bikerglen/usb-volume-knob/mechanical/puck_v2_v16_grayhill_encoder_v7_bottom.stl

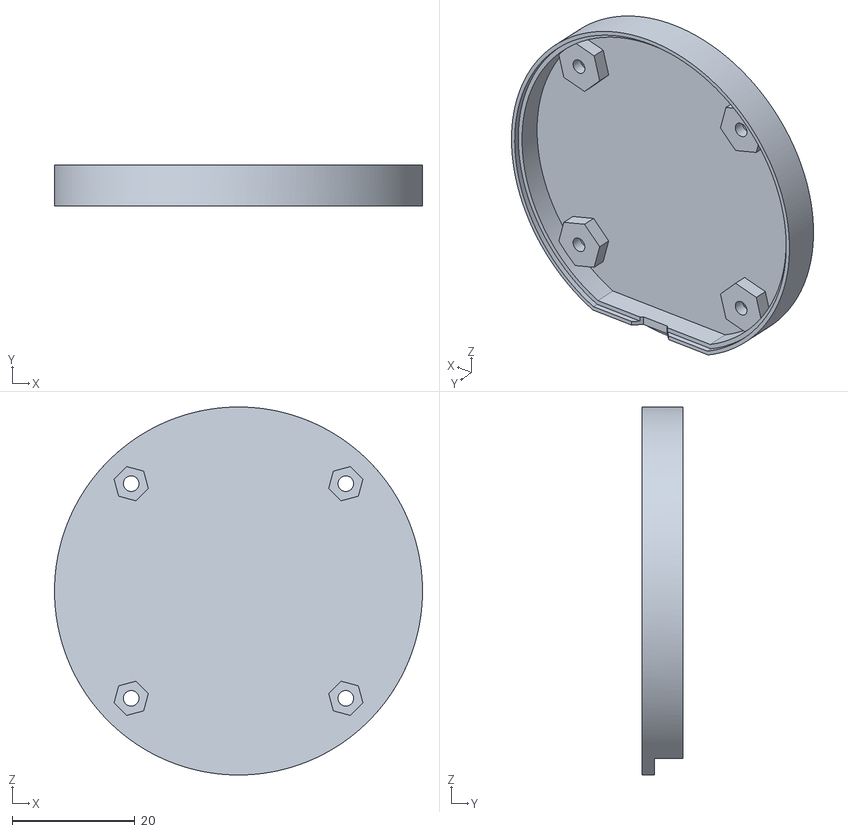
[picture p1: CAD file, 2020-03-15]
mechanical/puck_v2_v16_grayhill_encoder_v7_bottom.stl
60.0 x 6.65 x 60.0
