bikerglen/usb-volume-knob/mechanical/puck_v2_v16_grayhill_encoder_v7_top.stl

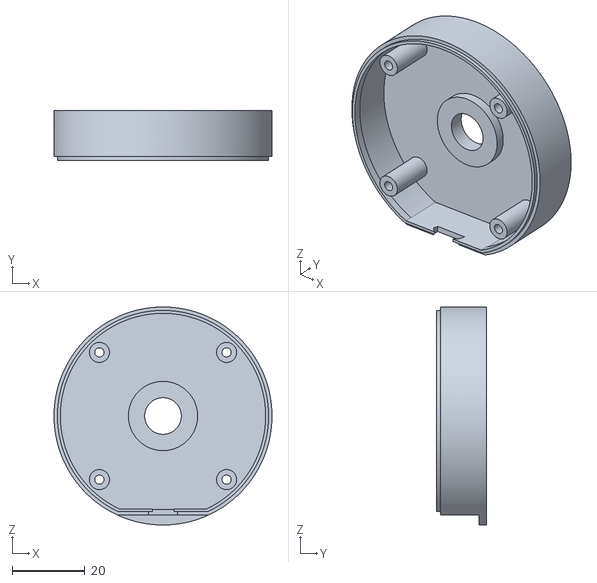
[picture p2: CAD file, 2020-03-15]
mechanical/puck_v2_v16_grayhill_encoder_v7_top.stl
60.0 x 13.6 x 60.0
