bikerglen/usb-volume-knob/(list of files, cad)

Other CAD files:
mechanical/puck_v2_v16_grayhill_encoder v9.f3z
