bikerglen/usb-volume-knob/boards/grayhill-knob-board.brd

## EAGLE design boards/grayhill-knob-board.brd (2020-03-15)

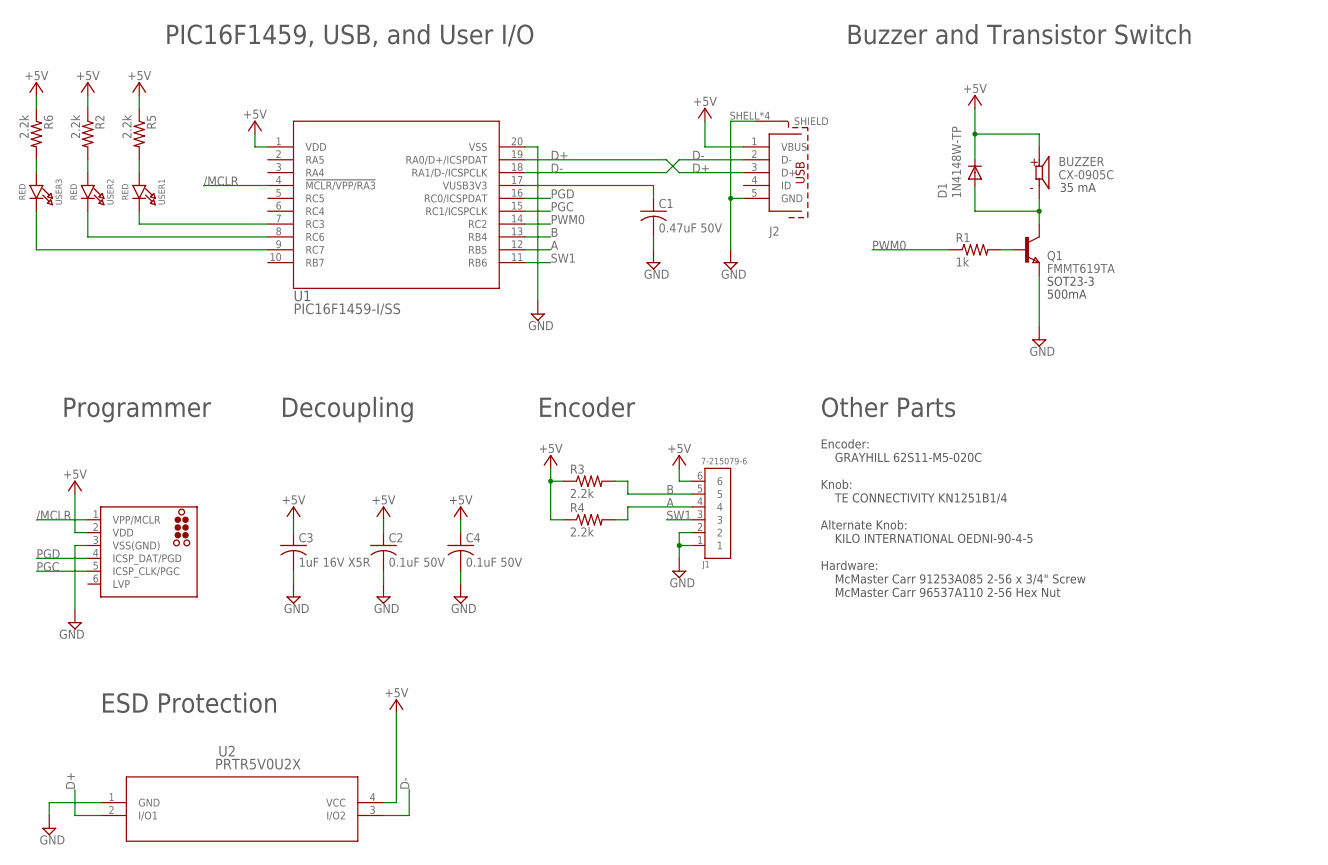
[picture p3: schematic grayhill-knob-board.sch]

Parts:
BUZZER: CX-0905C; CUI_CX-0905C
C1: 0.47uF 50V; C1206K; MFR_PART_NO C1206C474K5RACTU
C2, C4: 0.1uF 50V; C1206K; MFR_PART_NO C1206S104M5RACTU
C3: 1uF 16V X5R; C1210; MFR_PART_NO C1210C105K4PACTU
D1: 1N4148W-TP; SOD123
J1: 7-215079-6; TE_7-215079-6
J2: 629105136821
J3: TC2030-MCP-NL
Q1: FMMT619TA; SOT-23
R1: 1k; R0805
R2, R3, R4, R5, R6: 2.2k; R0805
U1: PIC16F1459-I/SS; SSOP20_MC
U2: PRTR5V0U2X; SOT143B
USER1, USER2, USER3: RED; CHIPLED_0805_NOOUTLINE

Connections:
+5V: BUZZER.P, C2.1, C3.1, C4.1, D1.C, J1.6, J2.1 (VBUS), J3.2 (VDD), R2.1, R3.1, R4.1, R5.1, R6.1, U1.1 (VDD), U2.4 (VCC)
/MCLR: J3.1 (VPP/MCLR), U1.4 (!MCLR/VPP/RA3)
A: J1.4, R4.2, U1.12 (RB5)
B: J1.5, R3.2, U1.13 (RB4)
D+: J2.3 (D+), U1.19 (RA0/D+/ICSPDAT), U2.2 (I/O1)
D-: J2.2 (D-), U1.18 (RA1/D-/ICSPCLK), U2.3 (I/O2)
GND: C1.2, C2.2, C3.2, C4.2, J1.1, J1.2, J2.5 (GND), J2.SHELL (SHIELD), J2.SHELL1 (SHIELD), J2.SHELL2 (SHIELD), J2.SHELL3 (SHIELD), J3.3 (VSS(GND)), Q1.2 (E), U1.20 (VSS), U2.1 (GND)
unnamed: R6.2, USER3.A
unnamed: R2.2, USER2.A
unnamed: R5.2, USER1.A
unnamed: Q1.3 (B), R1.2
OUT0: BUZZER.N, D1.A, Q1.1 (C)
PGC: J3.5 (ICSP_CLK/PGC), U1.15 (RC1/ICSPCLK)
PGD: J3.4 (ICSP_DAT/PGD), U1.16 (RC0/ICSPDAT)
PWM0: R1.1, U1.14 (RC2)
SW1: J1.3, U1.11 (RB6)
USER1: U1.7 (RC3), USER1.C
USER2: U1.8 (RC6), USER2.C
USER3: U1.9 (RC7), USER3.C
VUSB: C1.1, U1.17 (VUSB3V3)

Notes on the sheet:
SOT23-3
500mA
PIC16F1459, USB, and User I/O
Buzzer and Transistor Switch
Programmer
Decoupling
35 mA
ESD Protection
Encoder
Encoder: GRAYHILL 62S11-M5-020C Knob: TE CONNECTIVITY KN1251B1/4 Alternate Knob: KILO INTERNATIONAL OEDNI-90-4-5 Hardware: McMaster Carr 91253A085 2-56 x 3/4" Screw McMaster Carr 96537A110 2-56 Hex Nut
Other Parts

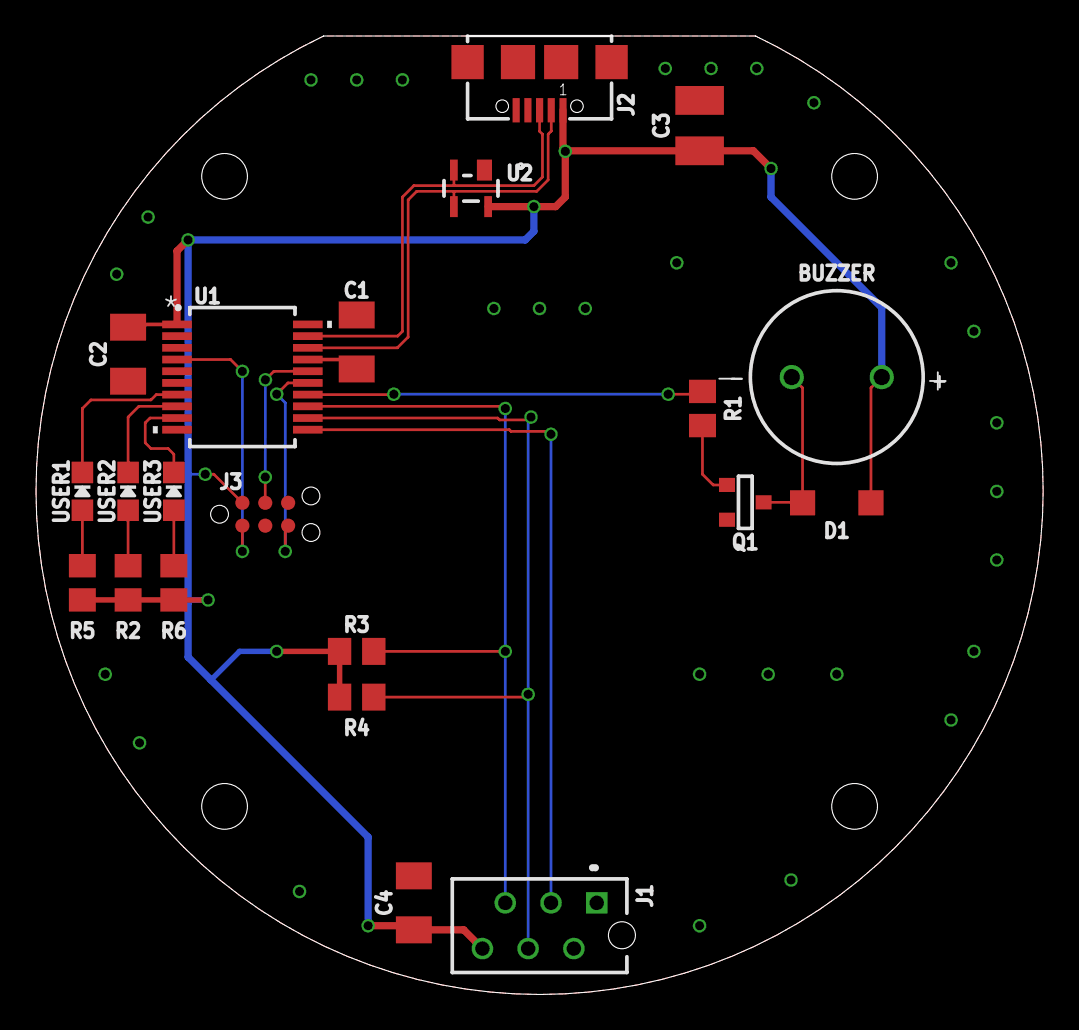
[picture p4: board grayhill-knob-board.brd from above]

Board: 2 copper layers, 56.0 x 53.2 mm, 21 parts (0 on the bottom side), 20 nets.
